hoilett/Bit-the-RoboDawg/Pictures_Videos/20160526_101735.jpg

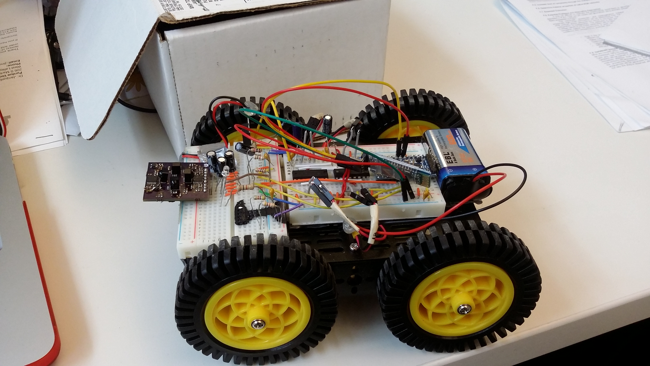
Pictures_Videos/20160526_101735.jpg
