hoilett/Bit-the-RoboDawg/PCB_Designs/BitBeaconV2/BitBeaconV2.png

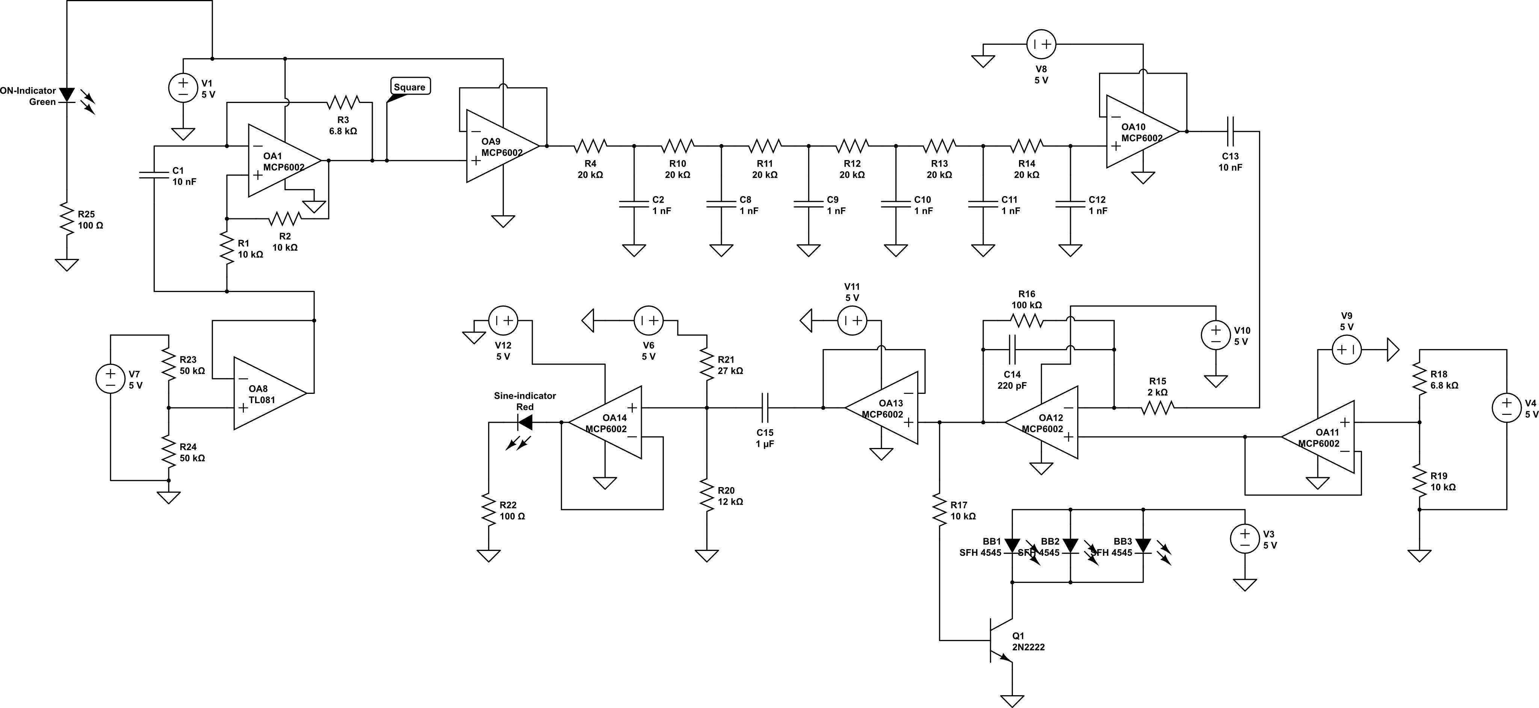
PCB_Designs/BitBeaconV2/BitBeaconV2.png
