hoilett/Bit-the-RoboDawg/Pictures_Videos/BitReceptor_Bottom.png

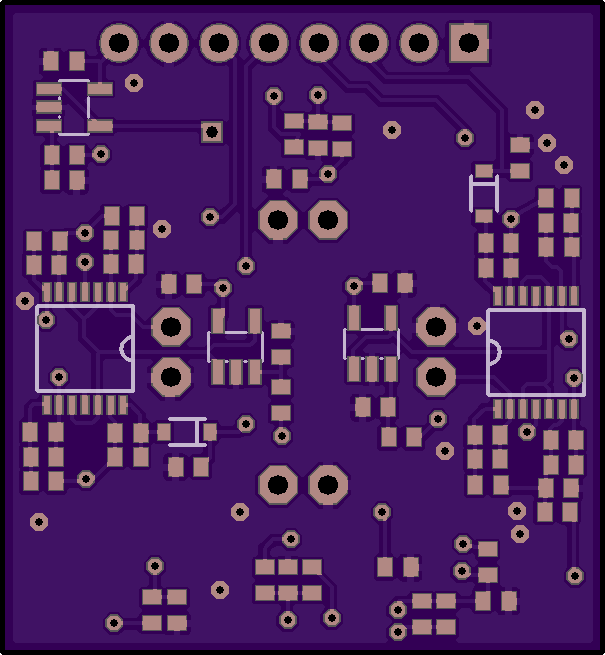
Pictures_Videos/BitReceptor_Bottom.png
