hoilett/Bit-the-RoboDawg/Pictures_Videos/BitReceptor_Top.png

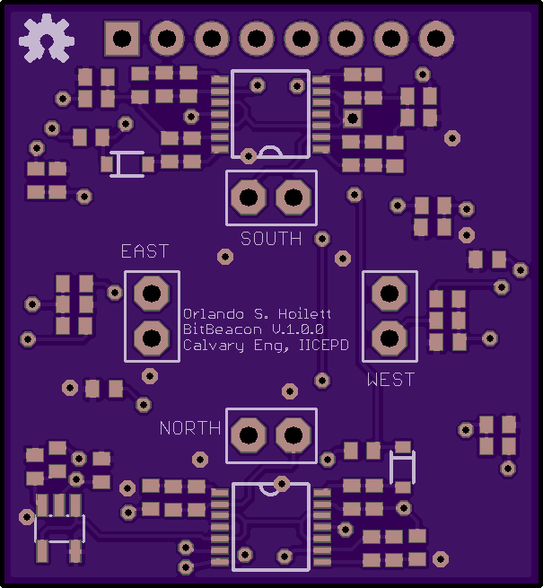
Pictures_Videos/BitReceptor_Top.png
