hoilett/Bit-the-RoboDawg/Bill_of_Materials/BOM-MotorDriver.xlsx

Bit the RoboDawg - BitMotorDriver V.1.0
BOM # | Comment | Description | Mounting Type | Package | Designator | Manufacturer | Manufacturer Part Number | Quantity | Supplier | Supplier Part Number | Price per unit | Price Total
1 | Arduino | Arduino Pro Mini 5V, 16 MHz | Through Hole | DIP | Arduino |  |  | 1 | SparkFun Electronics |  | $9.95 | $9.95
2 |  | 1 A, 4 Half Bridge Quadruple H-bridge | Through Hole | DIP |  | Texas Instruments | SN754410NE | 2 | Digi-Key | 296-9911-5-ND | $2.43 | $4.86
3 | Robot Chassis |  |  |  |  |  |  | 1 | SparkFun Electronics |  | $0.10 | $0.10
4 | Battery | 9 V battery |  |  |  |  |  | 1 |  |  | $0.10 | $0.10
6 | Breadboad | Half size breadboard |  |  |  |  |  | 1 |  |  | $2.70 | $2.70
7 |  |  |  |  |  |  |  | 1 |  |  | $0.24 | $0.24
8 |  |  |  |  |  |  |  | 1 |  |  |  | $0.00
9 |  |  |  |  |  |  |  | 3 |  |  |  | $0.00
10 |  |  |  |  |  |  |  | 1 |  |  |  | $0.00
11 |  |  |  |  |  |  |  |  |  |  |  | $0.00
 |  |  |  |  |  |  |  |  |  |  |  | $17.95 | Total
