hoilett/Bit-the-RoboDawg/Bill_of_Materials/BOM-BitReceptor.xlsx

Bit the RoboDawg - BitBeacon Signal V.1.0
BOM # | Comment | Description | Mounting Type | Package | Designator | Manufacturer | Manufacturer Part Number | Quantity | Supplier | Supplier Part Number | Price per unit | Price Total
1 | 100 nF capacitor | ceramic 100 nF capacitor, 10%, 16 V, X7R | SMD | 0402 | C4, C5, C6 | Samsung Electro-Mechanics America, Inc. | CL05B104KO5NNNC | 3 | Digi-Key | 1276-1001-1-ND | $0.10 | $0.30
2 | 1 nF capacitor | ceramic 1 nF capacitor, 10%, 50 V, X7R | SMD | 0402 | C1, C2, C3 | Murata Electronics North America | GRM155R71H102KA01D | 3 | Digi-Key | 490-1303-1-ND | $0.10 | $0.30
3 | 22.6 k resistor | 1%, 1/16 W | SMD | 0402 | R1, R2, R3, R4, R5 | Yageo | RC0402FR-0722K6L | 4 | Digi-Key | YAG3061CT-ND | $0.10 | $0.40
4 | 205 Ohm resistor | 1%, 1/16 W | SMD | 0402 | R6 | Yageo | RC0402FR-07205RL | 1 | Digi-Key | YAG3051CT-ND | $0.10 | $0.10
6 | AD8606 | Precision, Low Noise Amplifier, Rail-to-Rail Input and Output, Single Supply, Dual Op Amp | SMD | 8-MSOP | FGEN | Analog Devices, Inc. | AD8606ARMZ-REEL | 1 | Digi-Key | AD8606ARMZREELCT-ND | $2.70 | $2.70
7 | MCP6001 | Rail-to-Rail Input and Output, Single Supply, Single Op Amp | SMD | SOT23-5 | VREF | Microchip Technology | MCP6001T-I/OT | 1 | Digi-Key | MCP6001T-I/OTCT-ND | $0.24 | $0.24
8 | 2N2222A | NPN Transistor, General Purpose, 800 mA | Through Hole | TO | Q1 |  |  | 1 | Amazon.com |  |  | $0.00
9 | SFH 4545 | IR LED | Through Hole |  | LD1, LD2, LD3 |  |  | 3 |  |  | $0.59 | $1.77
10 | AA Battery Holder | Holds 4 AA Batteries |  |  |  |  |  | 1 |  |  | $2.72 | $2.72
11 | AA Batteries | 4Pack Rechargeable AA Batteries, NiMH, 1.2 V, 2400 mAh |  |  | BATTERY | Duracell | Model Number: DC1500B4N | 1 | Duracell on Amazon.com | ASIN: B00007ISWA, UPC: 041333661551 041333007632 041333695877 | $3.85 | $3.85
 |  |  |  |  |  |  |  |  |  |  |  | $12.38 | Total
