hoilett/Bit-the-RoboDawg/PCB_Designs/BitReceptor_Breakouts/Type_02/BitReceptor_Type_02.brd

## EAGLE design PCB_Designs/BitReceptor_Breakouts/Type_02/BitReceptor_Type_02.brd (2016-05-23)

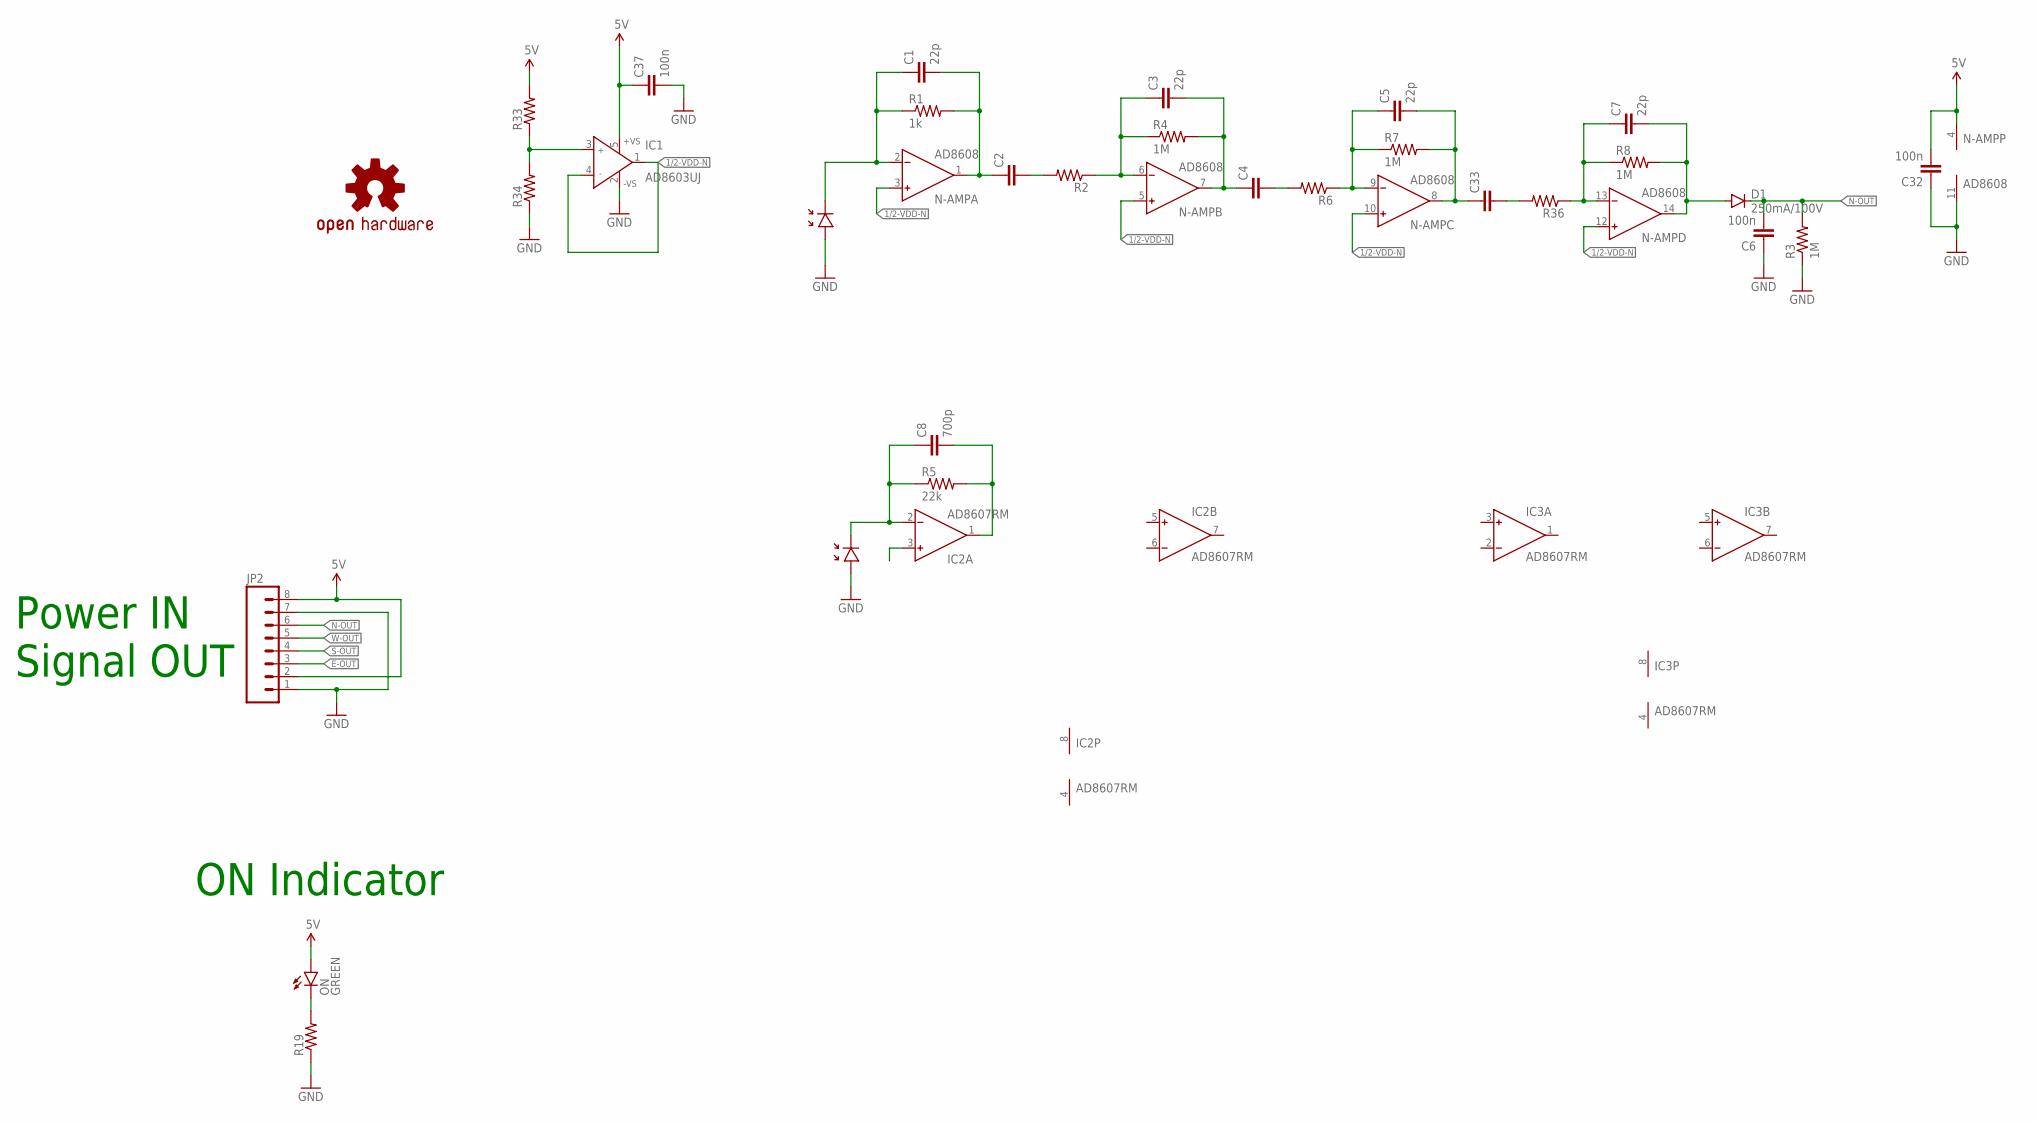
[picture p5: schematic BitReceptor_Type_02.sch]

Parts:
C1, C3, C5, C7: 22p; C0402
C2, C4, C33: C-EUC0402; C0402
C6, C32, C37: 100n; C0402
C8: 700p; C0402
D1: 250mA/100V; SOD-323
IC1: AD8603UJ; SOT23-5
IC2, IC3: AD8607RM; MSOP08
JP2: M08NO_SILK; 1X08_PIN1_NO_SILK
LOGO1: OSHW-LOGOS; OSHW-LOGO-S
N-AMP: AD8608; TSSOP14
N-PD1, N-PD2: BPW46; PIN-PHOTODIODE
ON: GREEN; LED-0603
R1: 1k; R0402
R2, R6, R19, R33, R34, R36: R-US_R0402; R0402
R3, R4, R7, R8: 1M; R0402
R5: 22k; R0402

Connections:
1/2-VDD-N: IC1.1 (OUT), IC1.4 (IN-), N-AMP.3 (IN+), N-AMP.5 (IN+), N-AMP.10 (IN+), N-AMP.12 (IN+)
5V: C32.2, C37.1, IC1.5 (+VS), JP2.2, JP2.8, N-AMP.4 (V+), ON.A, R33.2
E-OUT: JP2.3
GND: C6.1, C32.1, C37.2, IC1.2 (-VS), JP2.1, JP2.7, N-AMP.11 (V-), N-PD1.1 (+), N-PD2.1 (+), R3.1, R19.1, R34.1
unnamed: C1.1, N-AMP.2 (IN-), N-PD1.2 (-), R1.1
unnamed: C8.1, IC2.2 (IN-), N-PD2.2 (-), R5.1
unnamed: C1.2, C2.1, N-AMP.1 (OUT), R1.2
unnamed: C8.2, IC2.1 (OUT), R5.2
unnamed: C3.1, N-AMP.6 (IN-), R2.1, R4.1
unnamed: C3.2, C4.1, N-AMP.7 (OUT), R4.2
unnamed: C5.1, N-AMP.9 (IN-), R6.1, R7.1
unnamed: C5.2, C33.1, N-AMP.8 (OUT), R7.2
unnamed: IC1.3 (IN+), R33.1, R34.2
unnamed: C7.1, N-AMP.13 (IN-), R8.1, R36.1
unnamed: C7.2, D1.A, N-AMP.14 (OUT), R8.2
unnamed: C2.2, R2.2
unnamed: C4.2, R6.2
unnamed: C33.2, R36.2
unnamed: ON.C, R19.2
N-OUT: C6.2, D1.C, JP2.6, R3.2
S-OUT: JP2.4
V+: IC2.8 (V+), IC3.8 (V+)
V-: IC2.4 (V-), IC3.4 (V-)
VREF: IC2.3 (IN+)
W-OUT: JP2.5

Notes on the sheet:
ON Indicator
Power IN Signal OUT

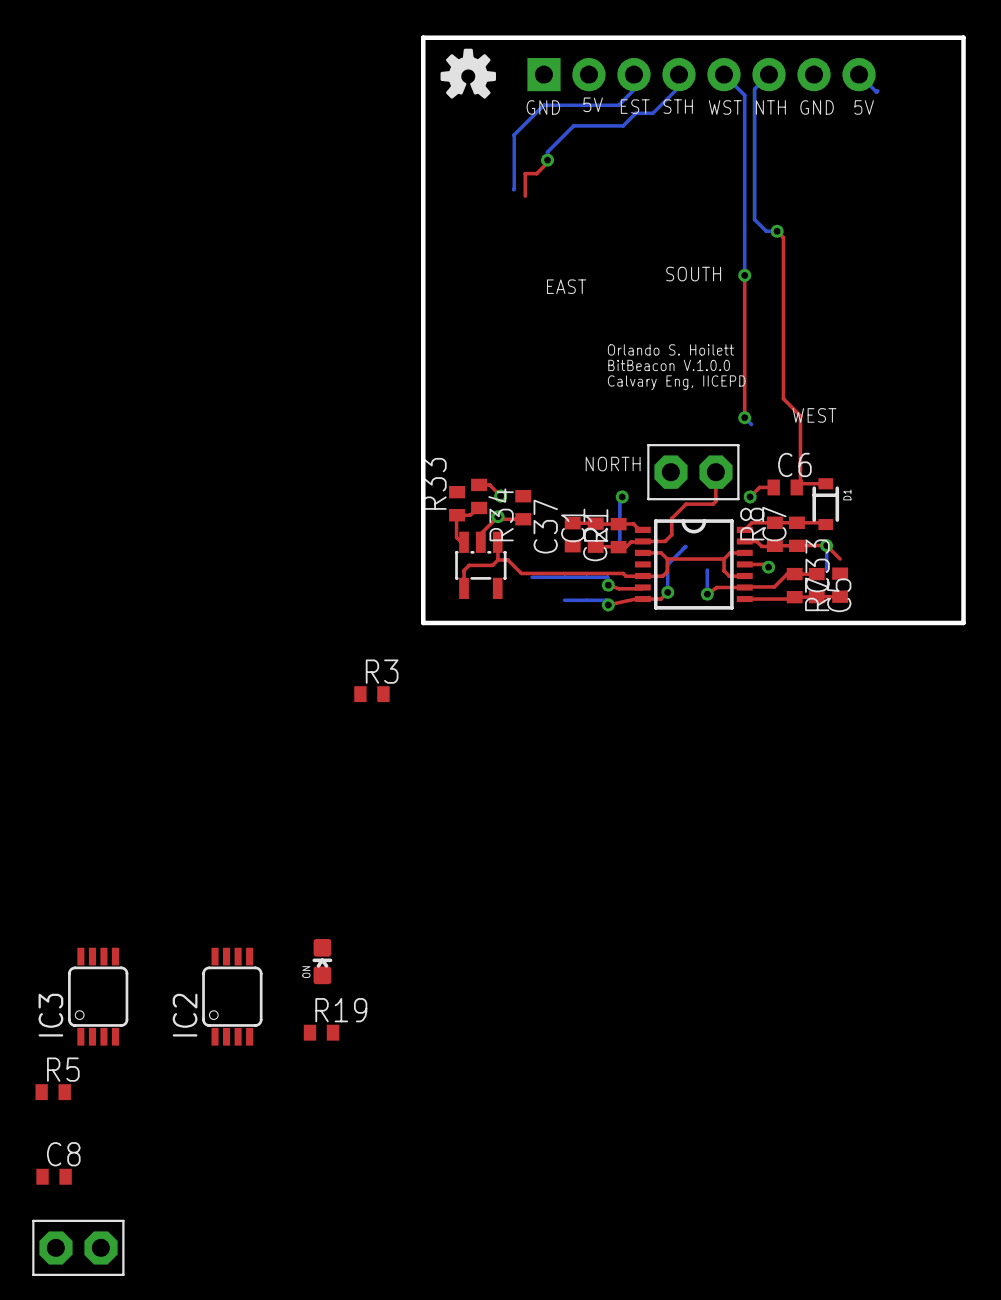
[picture p6: board BitReceptor_Type_02.brd from above]

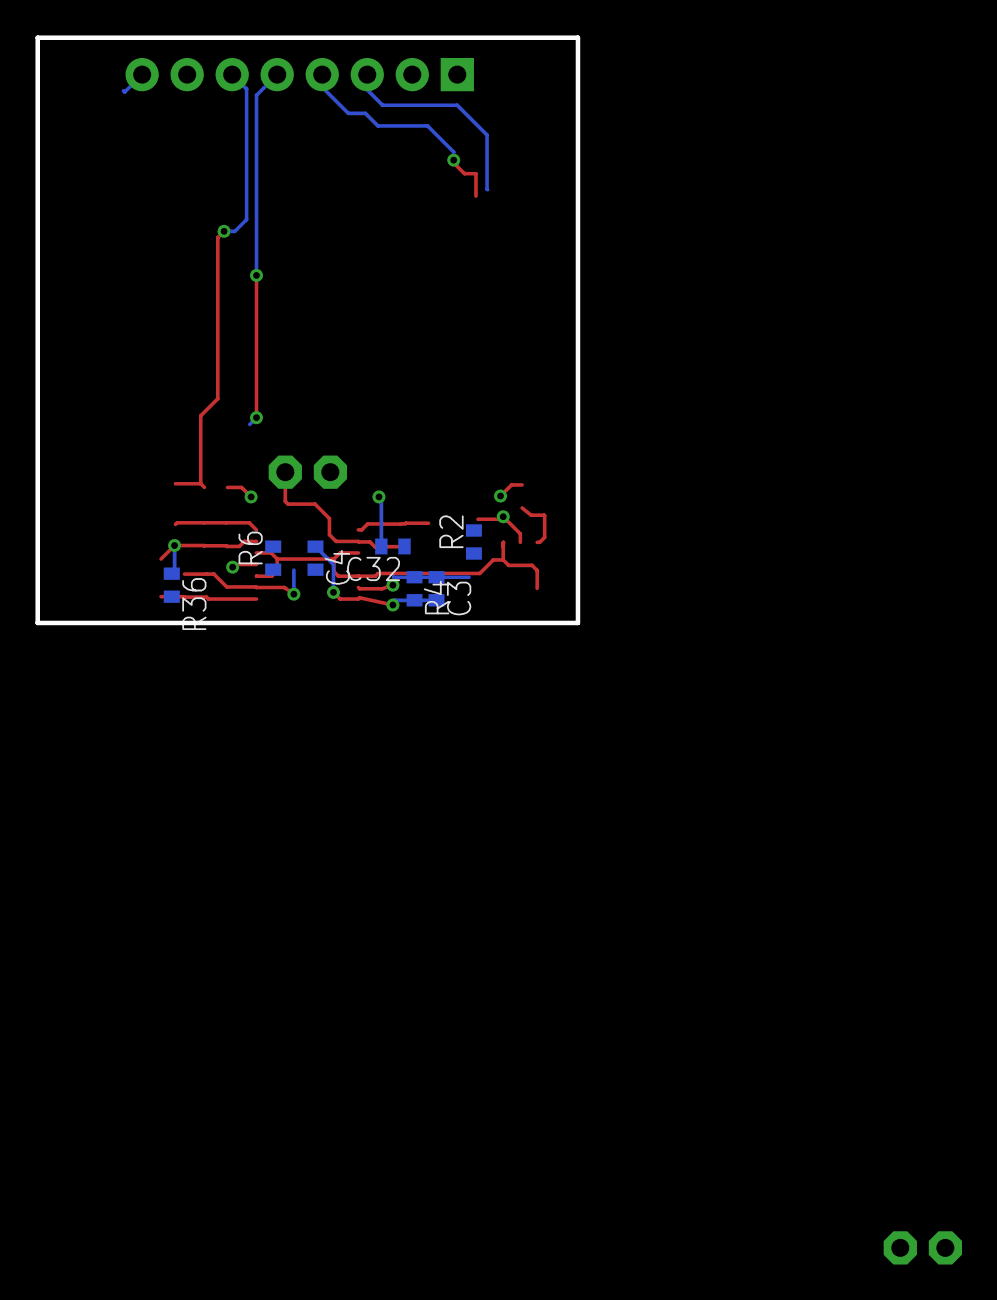
[picture p7: board BitReceptor_Type_02.brd from below]

Board: 2 copper layers, 30.5 x 33.0 mm, 33 parts (7 on the bottom side), 21 nets.
