hoilett/Bit-the-RoboDawg/PCB_Designs/BitReceptor_Breakouts/Type_01/BitReceptor_Type_01.brd

## EAGLE design PCB_Designs/BitReceptor_Breakouts/Type_01/BitReceptor_Type_01.brd (2016-05-23)

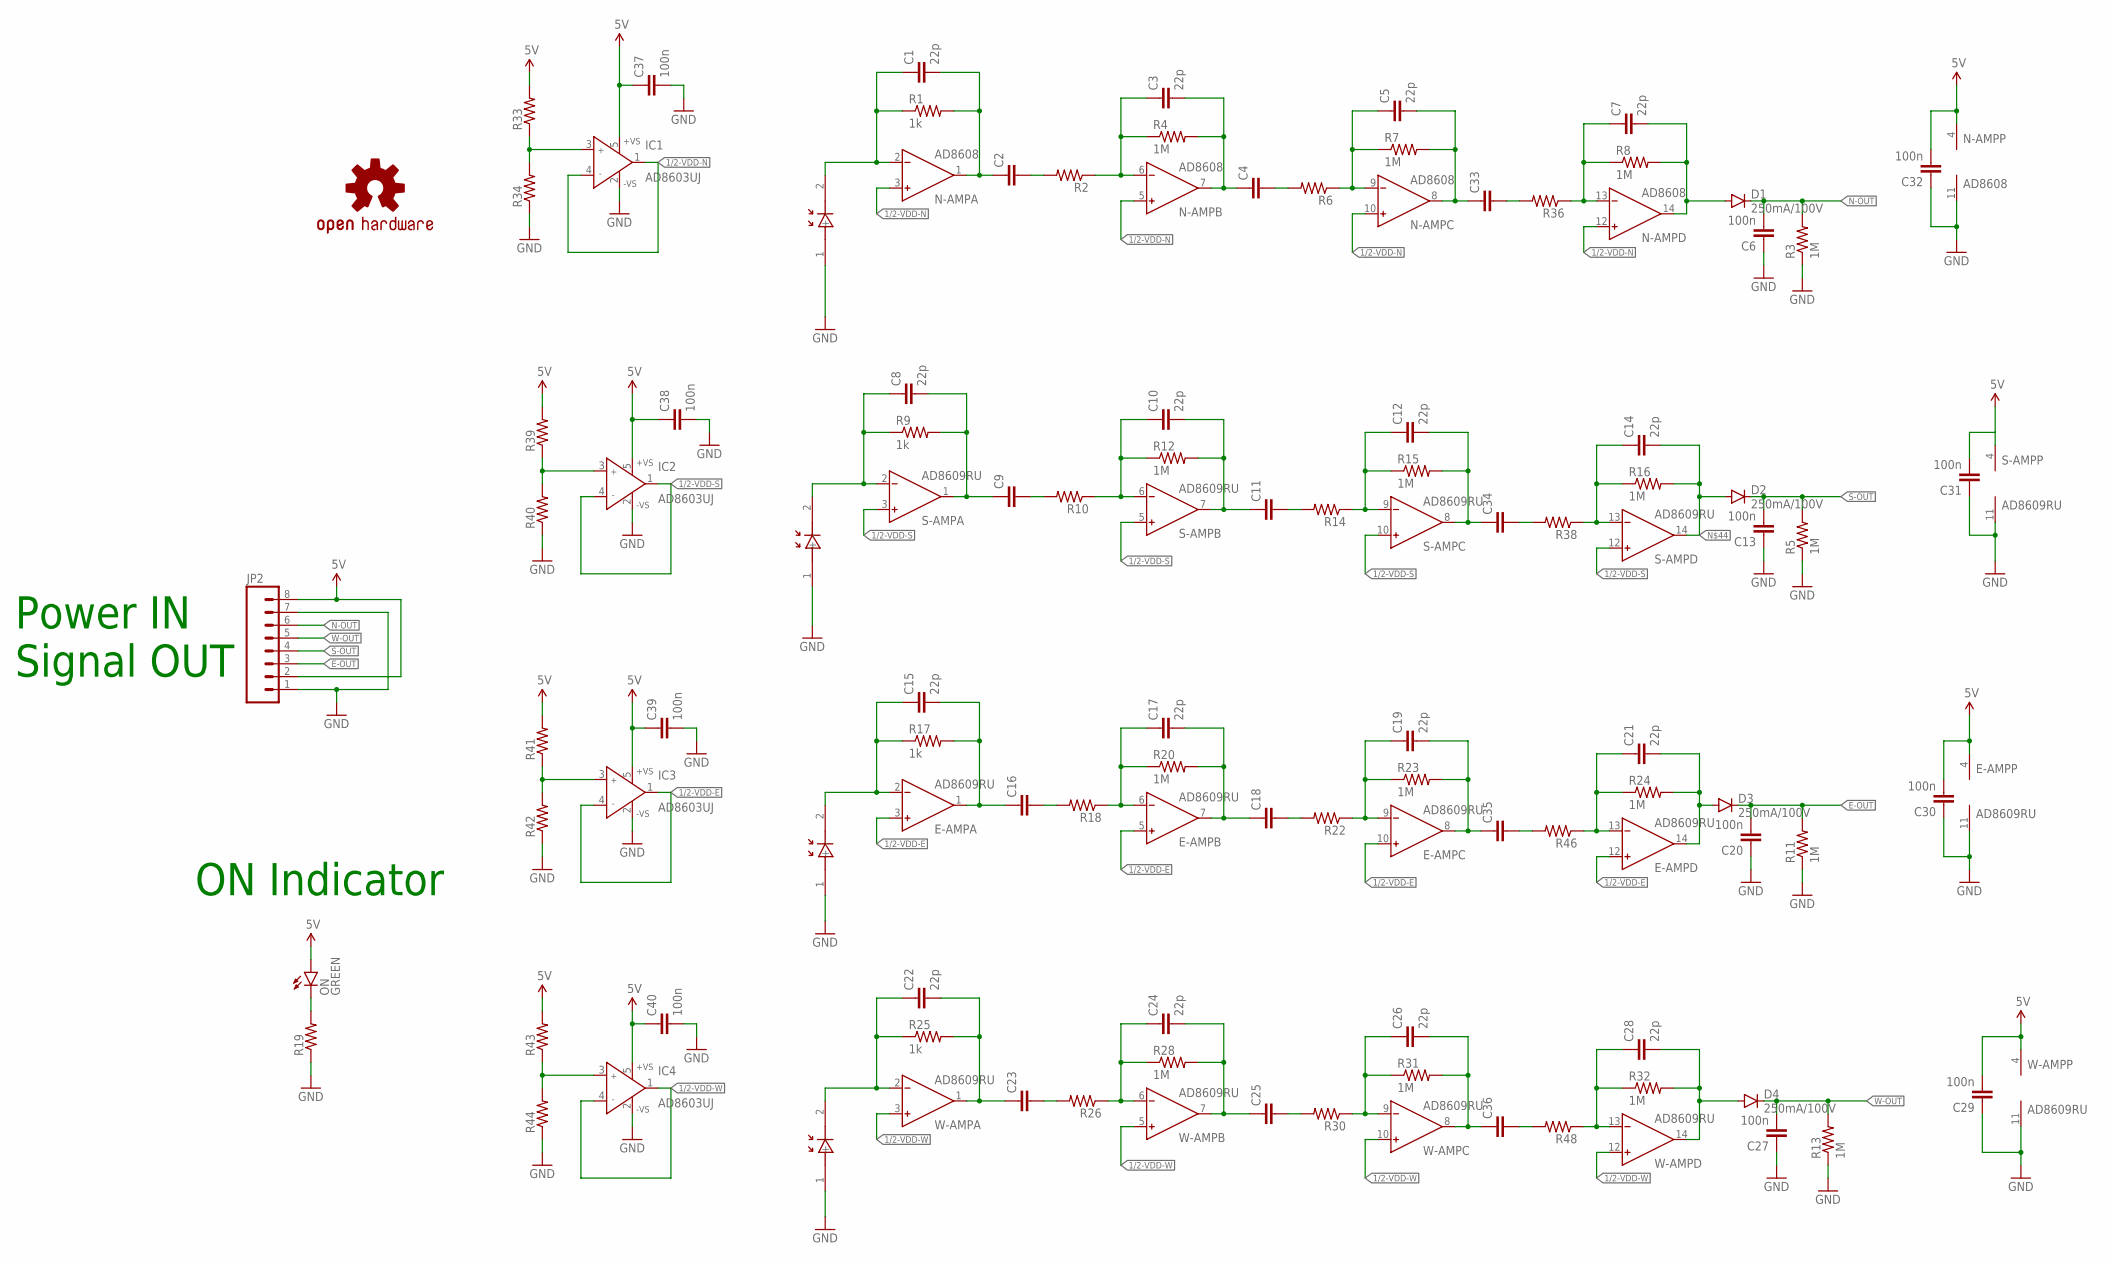
[picture p8: schematic BitReceptor_Type_01.sch]

Parts:
C1, C3, C5, C7, C8, C10, C12, C14, C15, C17, C19, C21, C22, C24, C26, C28: 22p; C0402
C2, C4, C9, C11, C16, C18, C23, C25, C33, C34, C35, C36: C-EUC0402; C0402
C6, C13, C20, C27, C29, C30, C31, C32, C37, C38, C39, C40: 100n; C0402
D1, D2, D3, D4: 250mA/100V; SOD-323
E-AMP: AD8609RU; TSSOP14
E-PD1: BPW46; PIN-PHOTODIODE
IC1, IC2, IC3, IC4: AD8603UJ; SOT23-5
JP2: M08NO_SILK; 1X08_PIN1_NO_SILK
LOGO1: OSHW-LOGOS; OSHW-LOGO-S
N-AMP: AD8608; TSSOP14
N-PD1: BPW46; PIN-PHOTODIODE
ON: GREEN; LED-0603
R1, R9, R17, R25: 1k; R0402
R2, R6, R10, R14, R18, R19, R22, R26, R30, R33, R34, R36, R38, R39, R40, R41, R42, R43, R44, R46, R48: R-US_R0402; R0402
R3, R4, R5, R7, R8, R11, R12, R13, R15, R16, R20, R23, R24, R28, R31, R32: 1M; R0402
S-AMP: AD8609RU; TSSOP14
S-PD1: BPW46; PIN-PHOTODIODE
W-AMP: AD8609RU; TSSOP14
W-PD1: BPW46; PIN-PHOTODIODE

Connections:
1/2-VDD-E: E-AMP.3 (IN+), E-AMP.5 (IN+), E-AMP.10 (IN+), E-AMP.12 (IN+), IC3.1 (OUT), IC3.4 (IN-)
1/2-VDD-N: IC1.1 (OUT), IC1.4 (IN-), N-AMP.3 (IN+), N-AMP.5 (IN+), N-AMP.10 (IN+), N-AMP.12 (IN+)
1/2-VDD-S: IC2.1 (OUT), IC2.4 (IN-), S-AMP.3 (IN+), S-AMP.5 (IN+), S-AMP.10 (IN+), S-AMP.12 (IN+)
1/2-VDD-W: IC4.1 (OUT), IC4.4 (IN-), W-AMP.3 (IN+), W-AMP.5 (IN+), W-AMP.10 (IN+), W-AMP.12 (IN+)
5V: C29.2, C30.2, C31.2, C32.2, C37.1, C38.1, C39.1, C40.1, E-AMP.4 (V+), IC1.5 (+VS), IC2.5 (+VS), IC3.5 (+VS), IC4.5 (+VS), JP2.2, JP2.8, N-AMP.4 (V+), ON.A, R33.2, R39.2, R41.2, R43.2, S-AMP.4 (V+), W-AMP.4 (V+)
E-OUT: C20.2, D3.C, JP2.3, R11.2
GND: C6.1, C13.1, C20.1, C27.1, C29.1, C30.1, C31.1, C32.1, C37.2, C38.2, C39.2, C40.2, E-AMP.11 (V-), E-PD1.1 (+), IC1.2 (-VS), IC2.2 (-VS), IC3.2 (-VS), IC4.2 (-VS), JP2.1, JP2.7, N-AMP.11 (V-), N-PD1.1 (+), R3.1, R5.1, R11.1, R13.1, R19.1, R34.1, R40.1, R42.1, R44.1, S-AMP.11 (V-), S-PD1.1 (+), W-AMP.11 (V-), W-PD1.1 (+)
unnamed: C1.1, N-AMP.2 (IN-), N-PD1.2 (-), R1.1
unnamed: C14.1, R16.1, R38.1, S-AMP.13 (IN-)
unnamed: C1.2, C2.1, N-AMP.1 (OUT), R1.2
unnamed: C8.1, R9.1, S-AMP.2 (IN-), S-PD1.2 (-)
unnamed: C3.1, N-AMP.6 (IN-), R2.1, R4.1
unnamed: C3.2, C4.1, N-AMP.7 (OUT), R4.2
unnamed: C5.1, N-AMP.9 (IN-), R6.1, R7.1
unnamed: C5.2, C33.1, N-AMP.8 (OUT), R7.2
unnamed: IC1.3 (IN+), R33.1, R34.2
unnamed: C7.1, N-AMP.13 (IN-), R8.1, R36.1
unnamed: C7.2, D1.A, N-AMP.14 (OUT), R8.2
unnamed: C10.1, R10.1, R12.1, S-AMP.6 (IN-)
unnamed: C10.2, C11.1, R12.2, S-AMP.7 (OUT)
unnamed: C12.1, R14.1, R15.1, S-AMP.9 (IN-)
unnamed: C12.2, C34.1, R15.2, S-AMP.8 (OUT)
unnamed: IC2.3 (IN+), R39.1, R40.2
unnamed: IC3.3 (IN+), R41.1, R42.2
unnamed: IC4.3 (IN+), R43.1, R44.2
unnamed: C15.1, E-AMP.2 (IN-), E-PD1.2 (-), R17.1
unnamed: C15.2, C16.1, E-AMP.1 (OUT), R17.2
unnamed: C17.1, E-AMP.6 (IN-), R18.1, R20.1
unnamed: C17.2, C18.1, E-AMP.7 (OUT), R20.2
unnamed: C19.1, E-AMP.9 (IN-), R22.1, R23.1
unnamed: C19.2, C35.1, E-AMP.8 (OUT), R23.2
unnamed: C28.1, R32.1, R48.1, W-AMP.13 (IN-)
unnamed: C21.1, E-AMP.13 (IN-), R24.1, R46.1
unnamed: C2.2, R2.2
unnamed: C22.1, R25.1, W-AMP.2 (IN-), W-PD1.2 (-)
unnamed: C22.2, C23.1, R25.2, W-AMP.1 (OUT)
unnamed: C24.1, R26.1, R28.1, W-AMP.6 (IN-)
unnamed: C24.2, C25.1, R28.2, W-AMP.7 (OUT)
unnamed: C26.1, R30.1, R31.1, W-AMP.9 (IN-)
unnamed: C26.2, C36.1, R31.2, W-AMP.8 (OUT)
unnamed: C4.2, R6.2
unnamed: C33.2, R36.2
unnamed: C34.2, R38.2
unnamed: C11.2, R14.2
unnamed: C9.2, R10.2
unnamed: C35.2, R46.2
unnamed: C18.2, R22.2
unnamed: C16.2, R18.2
unnamed: C36.2, R48.2
unnamed: C25.2, R30.2
unnamed: C14.2, D2.A, R16.2, S-AMP.14 (OUT)
unnamed: C23.2, R26.2
unnamed: C21.2, D3.A, E-AMP.14 (OUT), R24.2
unnamed: C28.2, D4.A, R32.2, W-AMP.14 (OUT)
unnamed: ON.C, R19.2
N-OUT: C6.2, D1.C, JP2.6, R3.2
S-AMP: C8.2, C9.1, R9.2, S-AMP.1 (OUT)
S-OUT: C13.2, D2.C, JP2.4, R5.2
W-OUT: C27.2, D4.C, JP2.5, R13.2

Notes on the sheet:
ON Indicator
Power IN Signal OUT

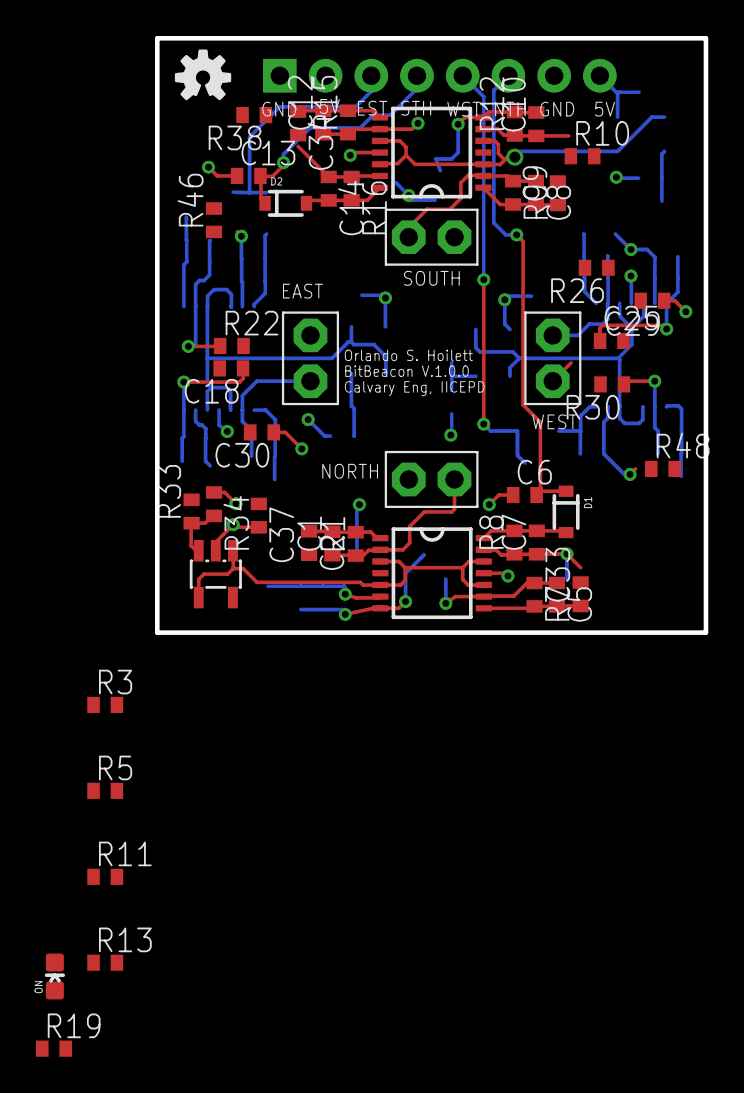
[picture p9: board BitReceptor_Type_01.brd from above]

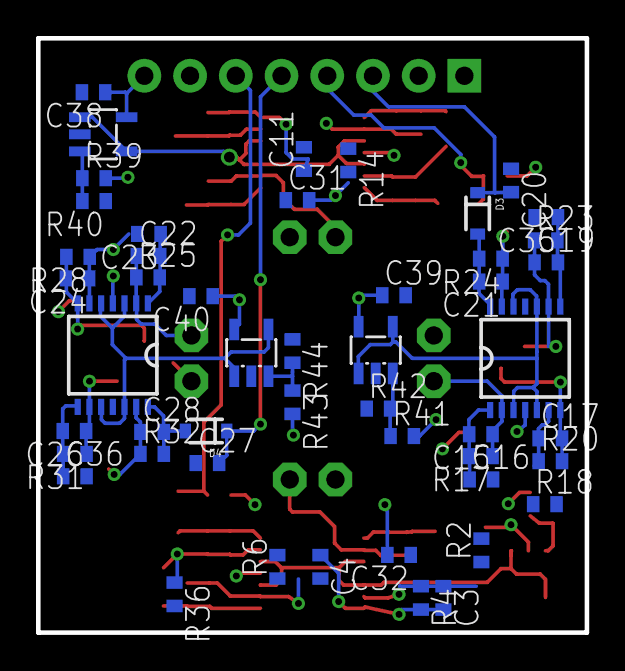
[picture p10: board BitReceptor_Type_01.brd from below]

Board: 2 copper layers, 30.5 x 33.0 mm, 100 parts (49 on the bottom side), 59 nets.
