hoilett/Bit-the-RoboDawg/PCB_Designs/BitBeacon/BitBeacon.brd

## EAGLE design PCB_Designs/BitBeacon/BitBeacon.brd (2016-05-22, an earlier design)

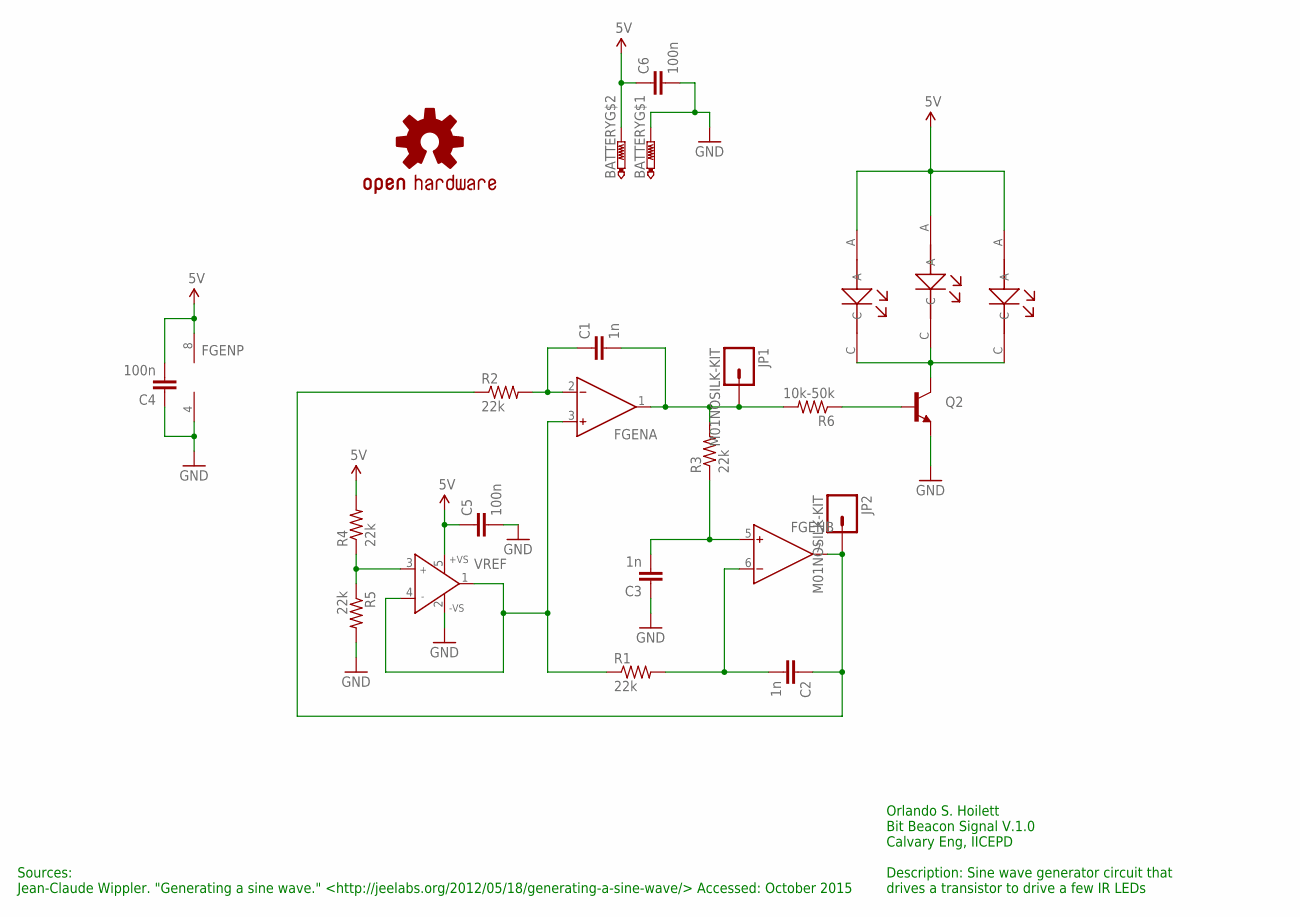
[picture p11: schematic BitBeacon.sch]

Parts:
BATTERY: BATT-CONNECT; HOLE
C1, C2, C3: 1n; C0402
C4, C5, C6: 100n; C0402
FGEN: AD8607RM; MSOP08
JP1, JP2: M01NOSILK-KIT; 1X01NS-KIT
LED1, LED2, LED3: LED
LOGO1: OSHW-LOGOS; OSHW-LOGO-S
Q2: TRANSISTOR_NPN2N3904; TO-92
R1, R2, R3, R4, R5: 22k; R0402
R6: 10k-50k; R0402
VREF: AD8603UJ; SOT23-5

Connections:
5V: BATTERY.P$2, C4.2, C5.1, C6.1, FGEN.8 (V+), LED1.A, LED2.A, LED3.A, R4.2, VREF.5 (+VS)
COSINE: C2.1, FGEN.7 (OUT), JP2.1, R2.1
GND: BATTERY.P$1, C3.1, C4.1, C5.2, C6.2, FGEN.4 (V-), Q2.1 (E), R5.2, VREF.2 (-VS)
unnamed: C3.2, FGEN.5 (IN+), R3.1
unnamed: C1.1, FGEN.2 (IN-), R2.2
unnamed: C2.2, FGEN.6 (IN-), R1.2
unnamed: FGEN.3 (IN+), R1.1, VREF.1 (OUT), VREF.4 (IN-)
unnamed: R4.1, R5.1, VREF.3 (IN+)
unnamed: LED1.C, LED2.C, LED3.C, Q2.3 (C)
unnamed: Q2.2 (B), R6.1
SINE: C1.2, FGEN.1 (OUT), JP1.1, R3.2, R6.2

Notes on the sheet:
Orlando S. Hoilett Bit Beacon Signal V.1.0 Calvary Eng, IICEPD Description: Sine wave generator circuit that drives a transistor to drive a few IR LEDs
Sources: Jean-Claude Wippler. "Generating a sine wave." <http://jeelabs.org/2012/05/18/generating-a-sine-wave/> Accessed: October 2015

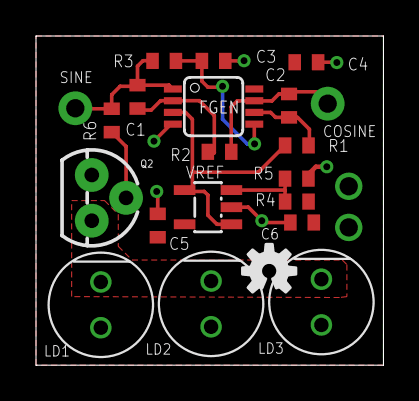
[picture p12: board BitBeacon.brd from above]

Board: 2 copper layers, 19.3 x 18.3 mm, 22 parts (0 on the bottom side), 11 nets.
