hoilett/Bit-the-RoboDawg/PCB_Designs/MotorDriver/MotoDriver.brd

## EAGLE design PCB_Designs/MotorDriver/MotoDriver.brd (2016-05-01)

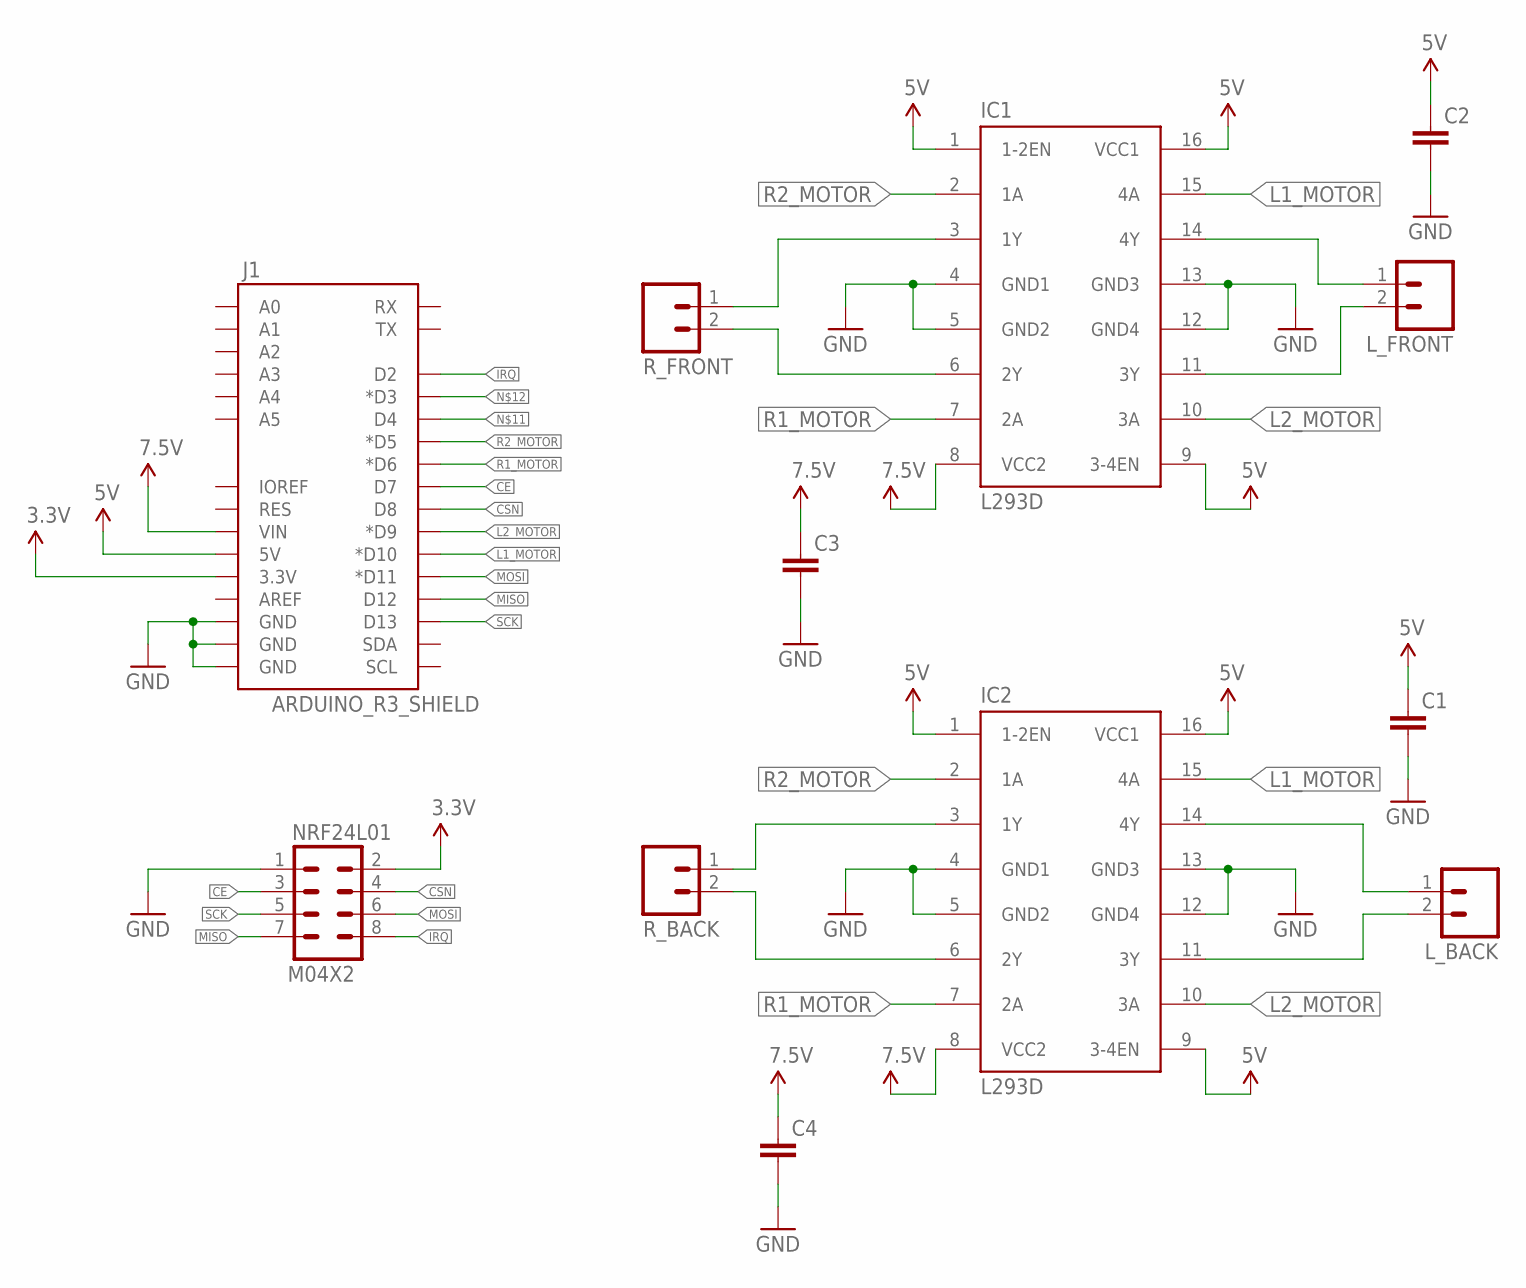
[picture p13: schematic MotoDriver.sch]

Parts:
C1, C2, C3, C4: C-EU050-024X044; C050-024X044
IC1, IC2: L293D; DIL16
J1: ARDUINO_R3_SHIELD; UNO_R3_SHIELD
L_BACK: M021X02_NO_SILK; 1X02_NO_SILK
L_FRONT: M021X02_NO_SILK; 1X02_NO_SILK
NRF24L01: M04X2; 2X4
R_BACK: M021X02_NO_SILK; 1X02_NO_SILK
R_FRONT: M021X02_NO_SILK; 1X02_NO_SILK

Connections:
3.3V: J1.3.3V, NRF24L01.2
5V: C1.1, C2.1, IC1.1 (1-2EN), IC1.9 (3-4EN), IC1.16 (VCC1), IC2.1 (1-2EN), IC2.9 (3-4EN), IC2.16 (VCC1), J1.5V
CE: J1.D7, NRF24L01.3
CSN: J1.D8, NRF24L01.4
GND: C1.2, C2.2, C3.2, C4.2, IC1.4 (GND1), IC1.5 (GND2), IC1.12 (GND4), IC1.13 (GND3), IC2.4 (GND1), IC2.5 (GND2), IC2.12 (GND4), IC2.13 (GND3), J1.GND@0 (GND), J1.GND@1 (GND), J1.GND@2 (GND), NRF24L01.1
IRQ: J1.D2, NRF24L01.8
L1_1: IC1.14 (4Y), L_FRONT.1
L1_2: IC2.14 (4Y), L_BACK.1
L1_MOTOR: IC1.15 (4A), IC2.15 (4A), J1.D10 (*D10)
L2_1: IC1.11 (3Y), L_FRONT.2
L2_2: IC2.11 (3Y), L_BACK.2
L2_MOTOR: IC1.10 (3A), IC2.10 (3A), J1.D9 (*D9)
MISO: J1.D12, NRF24L01.7
MOSI: J1.D11 (*D11), NRF24L01.6
R1_1: IC1.3 (1Y), R_FRONT.1
R1_2: IC2.3 (1Y), R_BACK.1
R1_MOTOR: IC1.7 (2A), IC2.7 (2A), J1.D6 (*D6)
R2_1: IC1.6 (2Y), R_FRONT.2
R2_2: IC2.6 (2Y), R_BACK.2
R2_MOTOR: IC1.2 (1A), IC2.2 (1A), J1.D5 (*D5)
SCK: J1.D13, NRF24L01.5
V_BATT: C3.1, C4.1, IC1.8 (VCC2), IC2.8 (VCC2), J1.VIN

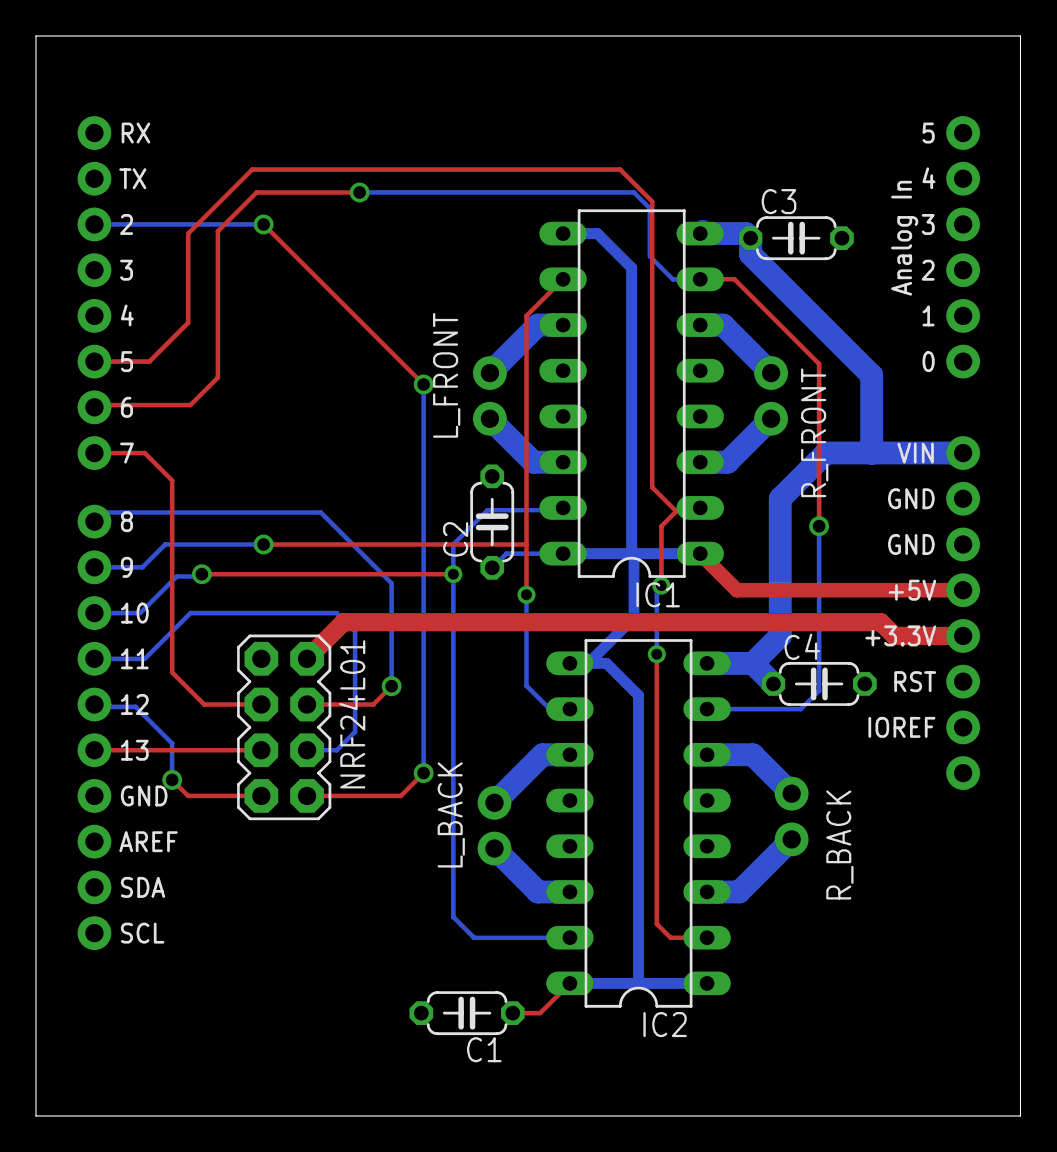
[picture p14: board MotoDriver.brd from above]

Board: 2 copper layers, 54.7 x 60.0 mm, 12 parts (0 on the bottom side), 22 nets.
