hoilett/Bit-the-RoboDawg/(commit log)

2016-03-27 Version 0.3.1 of light receiver for direction control
    [BitBeacon.brd, BitBeacon.sch]
2016-04-19 controlling robot chassis with nRF24L01 modules
2016-04-19 updated BitDriverRadio code to note which motor controls which wheel; updated ProjectPlan with a bit more description
2016-04-20 Small fixes to radio transmit code
    [BitRadioTransmit.ino]
2016-04-25 Added receiver with motor control file
2016-04-25 Added forward and reverse driving
    [BitReceiver_withCMDCode.ino, BitReceiver_withCMDCode_MotorDriving.ino, BitSender.ino]
2016-04-26 Added some extra noise filtering and hopefully smoothed the steering
    [BitReceiver_withCMDCode_MotorDriving.ino, BitSender.ino]
2016-05-01 added gitignore file to prevent adding Gerber files
2016-05-01 finishing up PCB
    [BitBeacon.brd, BitBeacon.sch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]
2016-05-01 deleted MotoDriver Gerber files from git
    [MotoDriver.GBL, MotoDriver.GBO, MotoDriver.GBS, MotoDriver.GTL, MotoDriver.GTO, MotoDriver.GTP, MotoDriver.GTS]
2016-05-01 updating controlling bit with light sensors
2016-05-01 testing excluding .b#x and .s#x files
    [BitBeacon.brd]
2016-05-01 finished and ordered PCB design for Bit Beacon
    [BitBeacon.brd, BitBeacon.sch]
2016-05-01 added .zip file containing Gerber files that were generated to order BitBeacon V.1.0.0 from OSH Park May 1, 2016
2016-05-03 updating BitBeacon design with a better high pass filter design and started teh BitBeacon_Emitter circuit
    [BitBeacon.brd, BitBeacon.sch, BitBeacon_Emitter.brd, BitBeacon_Emitter.sch]
2016-05-04 updating pcb files for emitter circuit
    [BitBeacon_Emitter.brd, BitBeacon_Emitter.sch]
2016-05-07 finished PCB design for Bit Beacon Emitter circuit and added datsheets for the LEDs that I think would work well.
    [BitBeacon_Emitter.brd, BitBeacon_Emitter.sch]
2016-05-19 updated Bit emitter PCB design with resistor and capacitor values. Added a bill of materials for BitBeacon and BitBeacon_Emitter
    [BitBeacon-BOM.xlsx, BitBeacon.brd, BitBeacon.sch, BitBeacon_Emitter-BOM.xlsx, BitBeacon_Emitter.brd, BitBeacon_Emitter.sch]
2016-05-19 deleted Bit_Beacon directory and replaced with BitBeacon directory
    [BitBeacon.brd, BitBeacon.sch]
2016-05-22 added resistor to peak detector circuit to discharge capacitor
    [BitBeacon.brd, BitBeacon.sch]
2016-05-22 updates to beacon emitter design
    [BitBeacon_Emitter.brd, BitBeacon_Emitter.sch]
2016-05-23 corrections to PCB for BitBeacon, updates on BitController
    [BitBeacon.brd, BitBeacon.sch]
2016-05-23 updates to code to include Bluetooth, updates to BitBeacon circuit to include labels, indicator LEDs, added BitBeacon Breakout to prototype different signal amplifier types
    [BitBeacon_Type_01.brd, BitBeacon_Type_01.sch, BitBeacon_Type_02.brd, BitBeacon_Type_02.sch]
2016-05-24 added a list of helpful git commands. also added a project log file to keep track of what we do
2016-05-28 changed the name of each Bill of Materials documents and added a folder for Pictures and Videos
    [BOM-BitBeacon.xlsx, BOM-BitReceptor.xlsx]
2016-05-28 deleted old bill of materials files
    [BitBeacon-BOM.xlsx, BitBeacon_Emitter-BOM.xlsx]
2016-06-02 test codes to add bluetooth and ultrasonic distance sensor to Bit
2016-06-11 made minor changes to BitBeacon
    [BitBeacon.brd, BitBeacon.sch]
2016-06-11 started adding to Bit Motor Driver Bill of Materials (BOM)
    [BOM-MotorDriver.xlsx]
2016-06-11 added ON indicator LED for power and pull down resistor for peak detector circuit
    [BitReceptor.brd, BitReceptor.sch]
2016-06-11 changed name of photosensor circuit to BitReceptor instead of BitBeacon which is now the name of the LED emitting circuit
    [BitReceptor_Type_01.brd, BitReceptor_Type_01.sch, BitReceptor_Type_02.brd, BitReceptor_Type_02.sch]
2016-06-11 updating controller code to include a filter to deal with reflection of light from BitBeacon off of reflective surfaces
2016-06-11 deleted BitBeacon_Breakouts due to name change of photosensor circuit to BitReceptor and LED emitter circuit
    [BitBeacon_Emitter.brd, BitBeacon_Emitter.sch, BitBeacon_Type_01.brd, BitBeacon_Type_01.sch, BitBeacon_Type_02.brd, BitBeacon_Type_02.sch]
2016-06-11 created Bill-of-Materials folder
    [BOM-BitBeacon.xlsx, BOM-BitReceptor.xlsx, BOM-MotorDriver.xlsx]
2016-06-13 added circuit diagram for version 2 of BitBeacon
